duplico/qc15_rfm75_board/(commit log)

2018-06-18 Initial import.
    [rfm75boosterpack-B.Cu.gbr, rfm75boosterpack-B.Mask.gbr, rfm75boosterpack-B.Paste.gbr, rfm75boosterpack-B.SilkS.gbr, rfm75boosterpack-Edge.Cuts.gbr, rfm75boosterpack-F.Cu.gbr, rfm75boosterpack-F.Mask.gbr, rfm75boosterpack-F.Paste.gbr]
2018-06-18 Add silkscreen for capacitor values.
    [rfm75boosterpack.kicad_pcb]
2018-06-19 Correct boosterpack component, replace, and reroute. Also regen gerbers.
    [rfm75boosterpack-B.Cu.gbr, rfm75boosterpack-B.Mask.gbr, rfm75boosterpack-B.Paste.gbr, rfm75boosterpack-B.SilkS.gbr, rfm75boosterpack-Edge.Cuts.gbr, rfm75boosterpack-F.Cu.gbr, rfm75boosterpack-F.Mask.gbr, rfm75boosterpack-F.Paste.gbr]
